jjmunoz23/Tesis/Post-Procesado/Pintado 2.jpeg

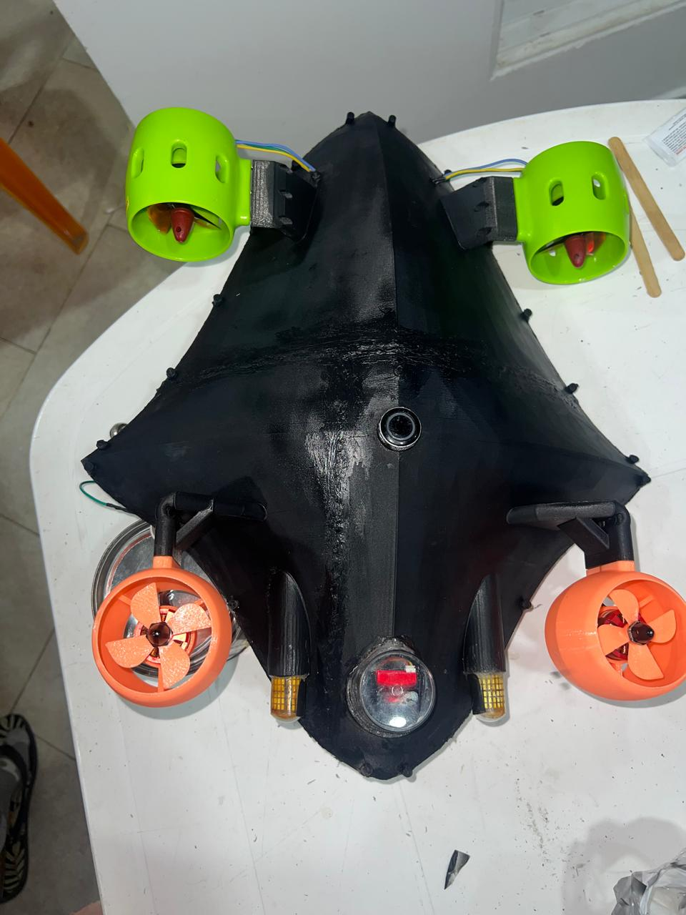
Post-Procesado/Pintado 2.jpeg
