jjmunoz23/Tesis/Post-Procesado/Pintado 1.jpeg

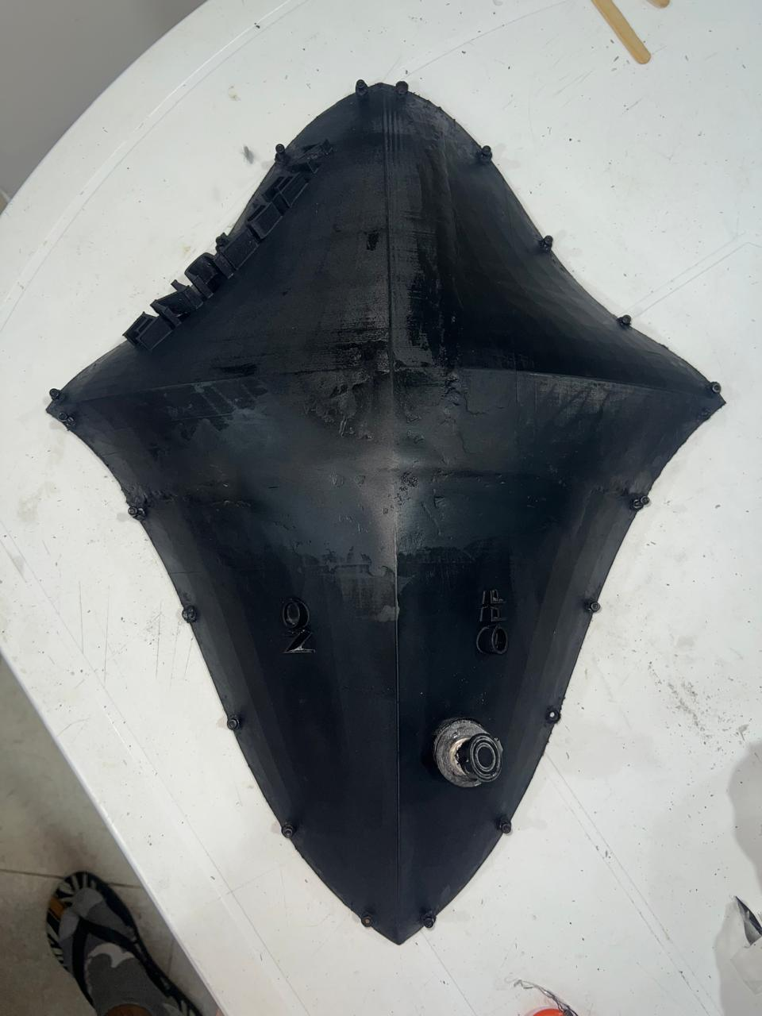
Post-Procesado/Pintado 1.jpeg
