jjmunoz23/Tesis/README.md

DESARROLLO DE UN VEHÍCULO SUBACUÁTICO NO TRIPULADO
