jjmunoz23/Tesis/Post-Procesado/Macillado.jpeg

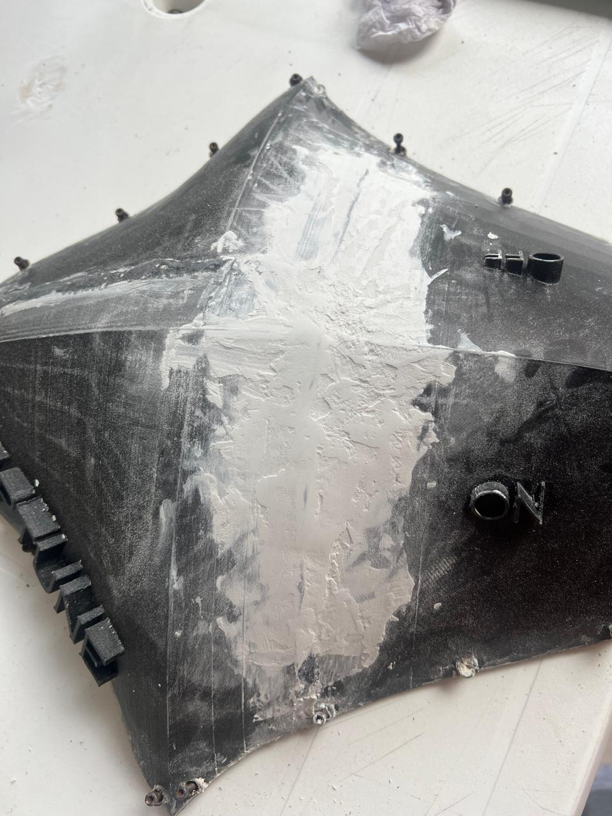
Post-Procesado/Macillado.jpeg
