jjmunoz23/Tesis/Post-Procesado/Pintado.jpeg

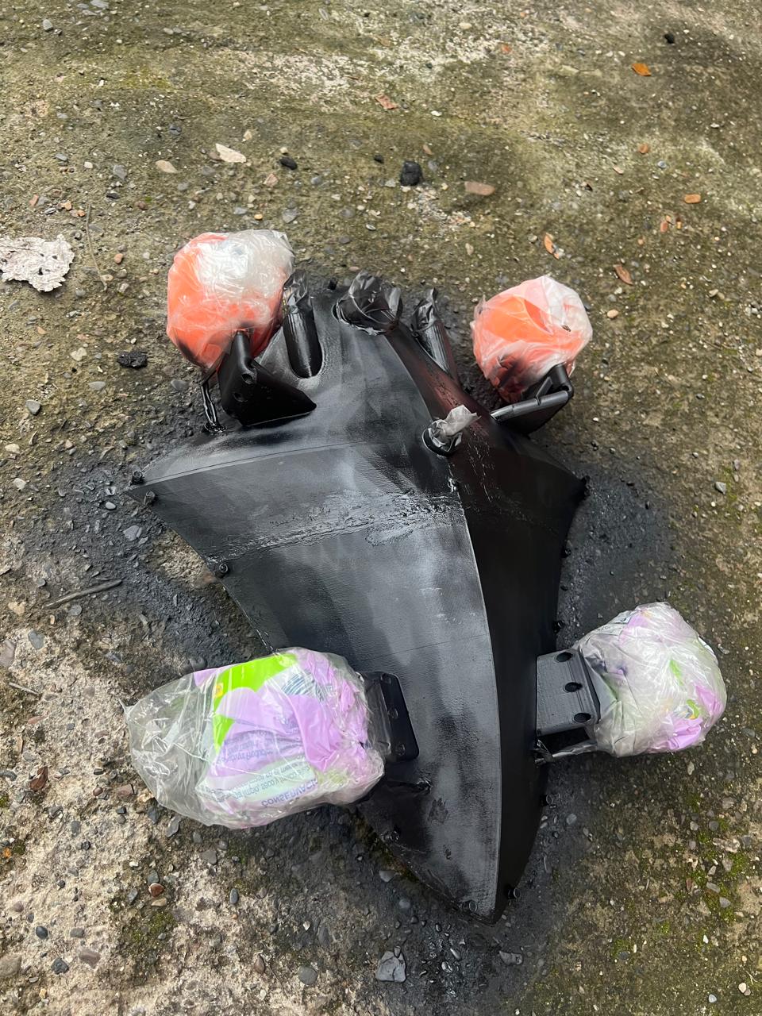
Post-Procesado/Pintado.jpeg
