jjmunoz23/Tesis/Diseño PCB/PCB_submarine_3_2025-03-08.dxf

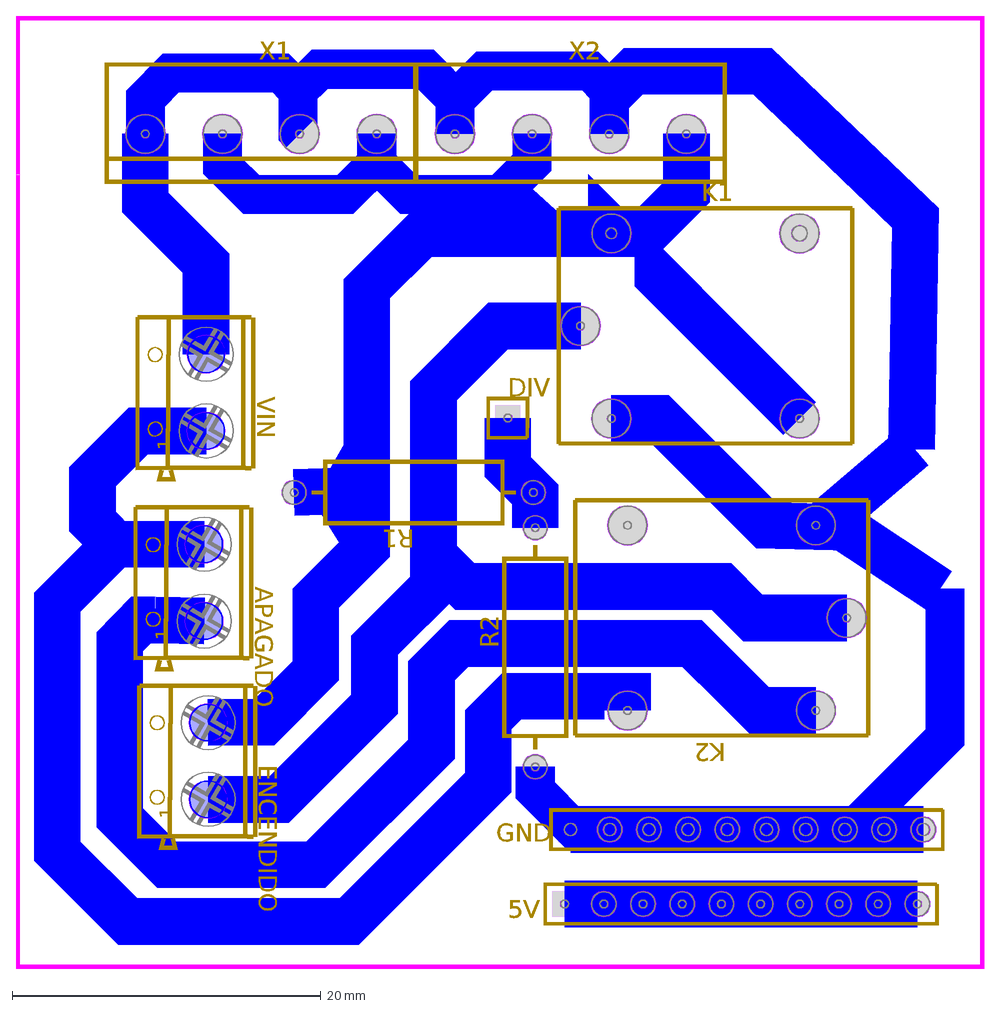
[picture p5: CAD file, 2025-07-16]
Diseño PCB/PCB_submarine_3_2025-03-08.dxf
DIV
5V
GND
X1
X2
ENCENDIDO
1
APAGADO
VIN
K1
K2
R1
R2
