jjmunoz23/Tesis/STL/Propela.STL

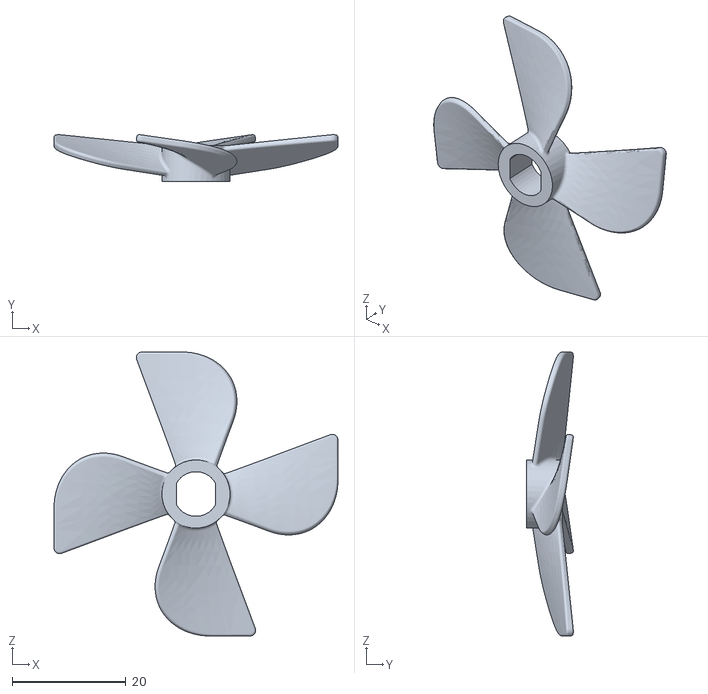
[picture p6: CAD file, 2025-06-20]
STL/Propela.STL
50.0 x 8.22 x 50.0
