jjmunoz23/Tesis/STL/Diseño final con soporte.STL

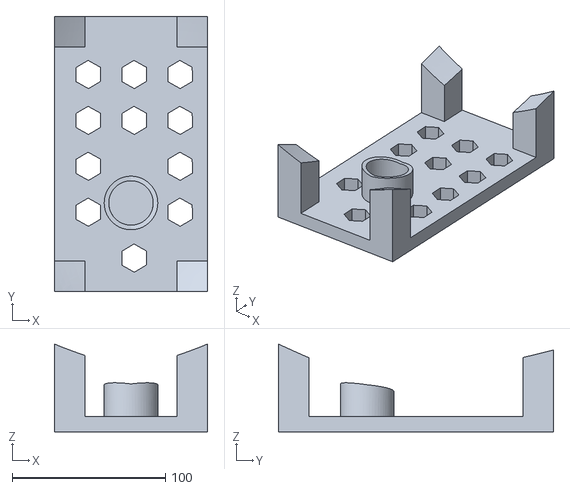
[picture p7: CAD file, 2025-06-20]
STL/Diseño final con soporte.STL
100.0 x 180.0 x 57.5
