jjmunoz23/Tesis/STL/soporte camara.STL

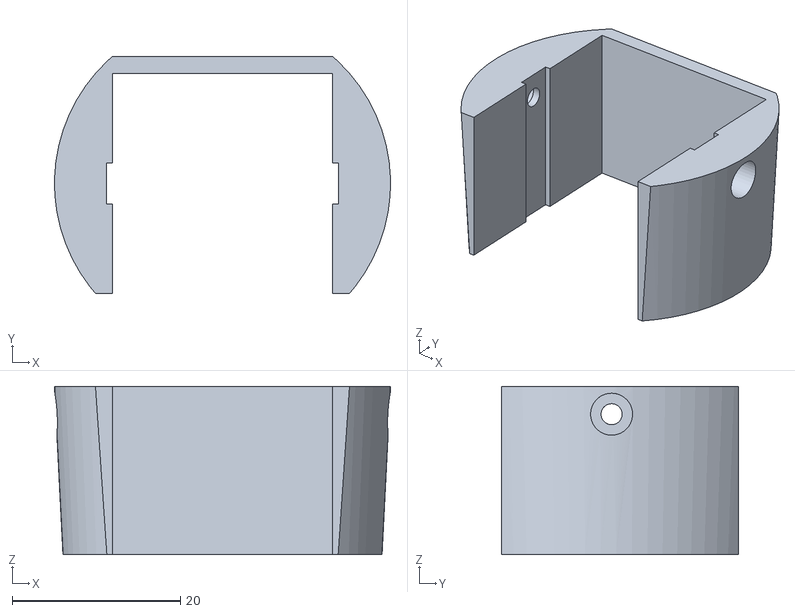
[picture p8: CAD file, 2025-06-20]
STL/soporte camara.STL
40.0 x 28.2 x 20.0
