jjmunoz23/Tesis/STL/Propela,ccw.STL

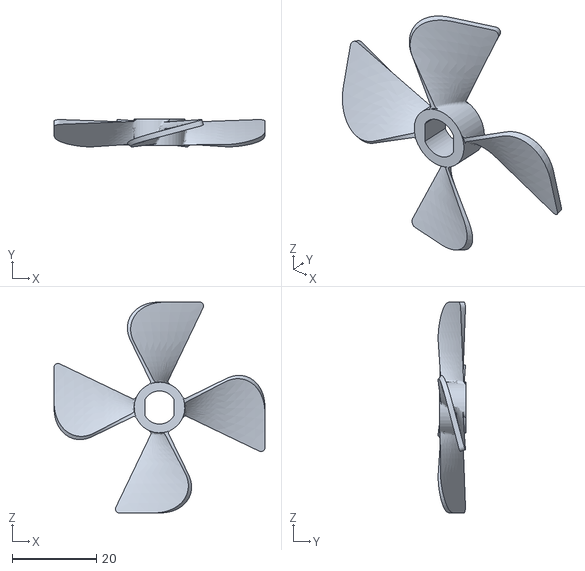
[picture p9: CAD file, 2025-06-20]
STL/Propela,ccw.STL
50.0 x 6.58 x 50.0
