jjmunoz23/Tesis/STL/tapa_camara.STL

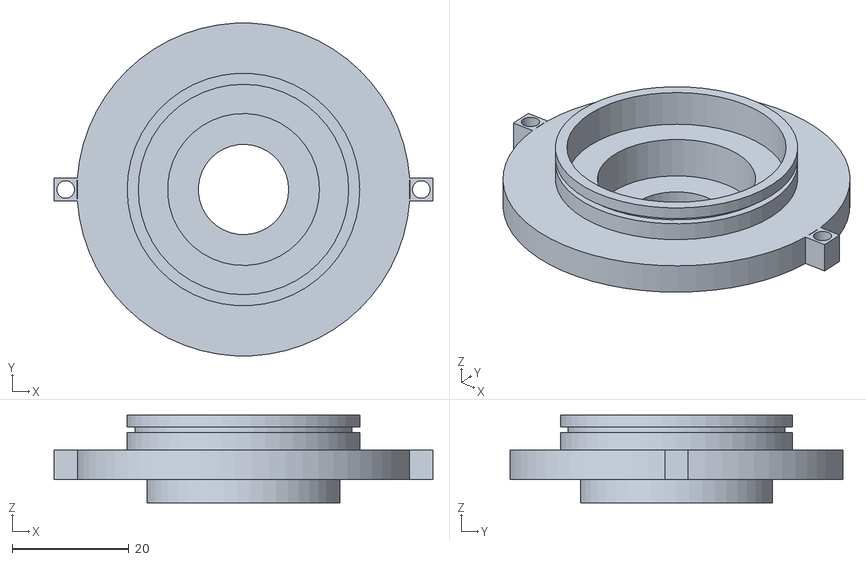
[picture p10: CAD file, 2025-06-20]
STL/tapa_camara.STL
64.9 x 56.9 x 15.0
