jjmunoz23/Tesis/STL/Diseño final.STL

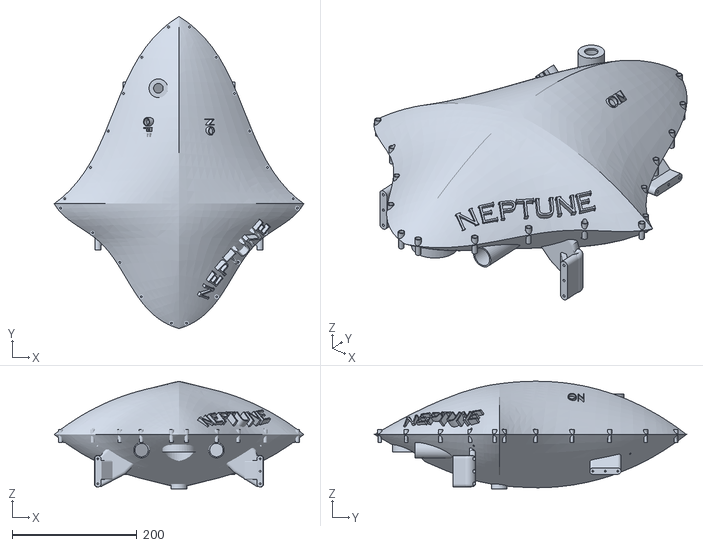
[picture p11: CAD file, 2025-06-20]
STL/Diseño final.STL
400.0 x 500.0 x 172.4
