jjmunoz23/Tesis/STL/tapa_encapsulado.STL

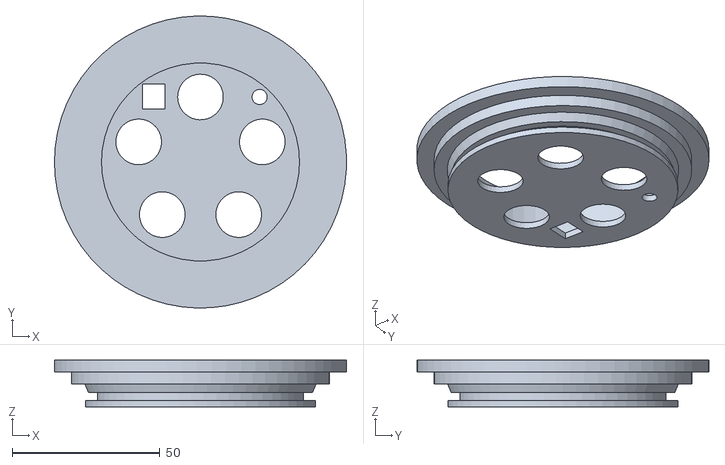
[picture p12: CAD file, 2025-06-20]
STL/tapa_encapsulado.STL
98.8 x 98.8 x 15.8
