jjmunoz23/Tesis/STL/Carcasa_Motor.STL

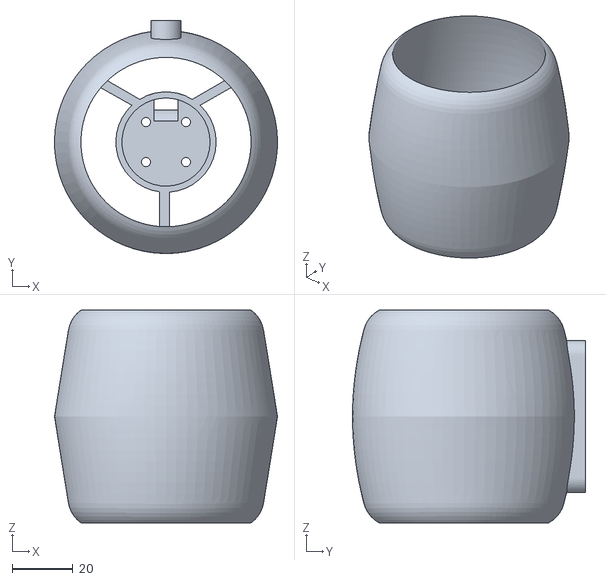
[picture p13: CAD file, 2025-06-20]
STL/Carcasa_Motor.STL
73.3 x 76.7 x 70.0
